Michi-Tsubaki/dynamic_heartbeat/cad/base/Assembly.SLDASM

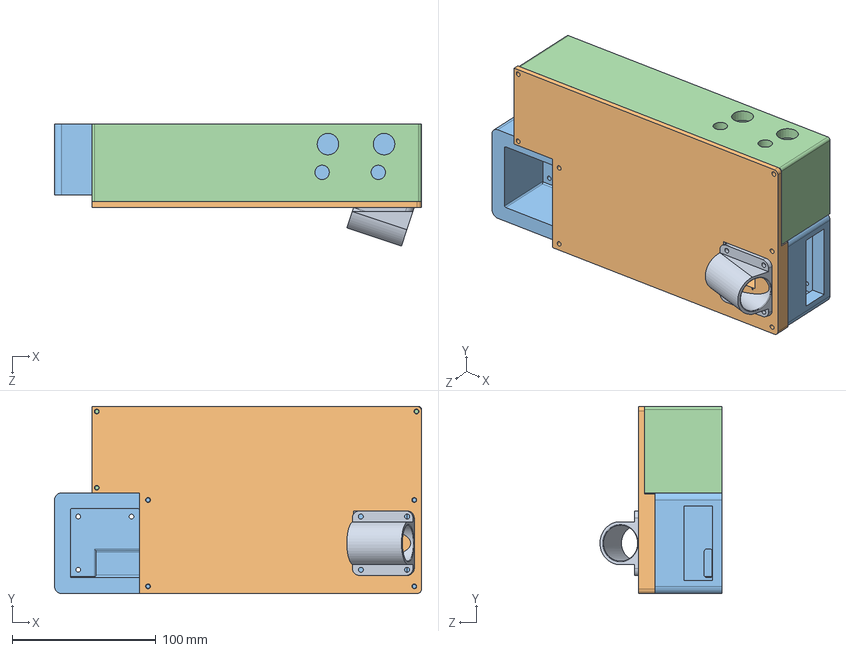
[picture p2: CAD file, 2026-11-08]
cad/base/Assembly.SLDASM
255.0 x 130.0 x 84.8 mm
air_pump_base
water_pump_base
top
finger_socket
