Michi-Tsubaki/dynamic_heartbeat/cad/base/sldprt/finger_socket.SLDPRT

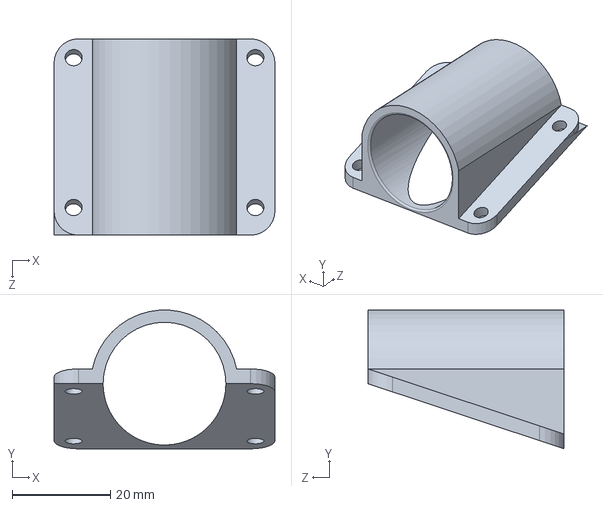
[picture p3: CAD file, 2026-11-08]
cad/base/sldprt/finger_socket.SLDPRT
45.0 x 28.2 x 40.0 mm
