Michi-Tsubaki/dynamic_heartbeat/cad/mold/stl/heart_mold_A_base.stl

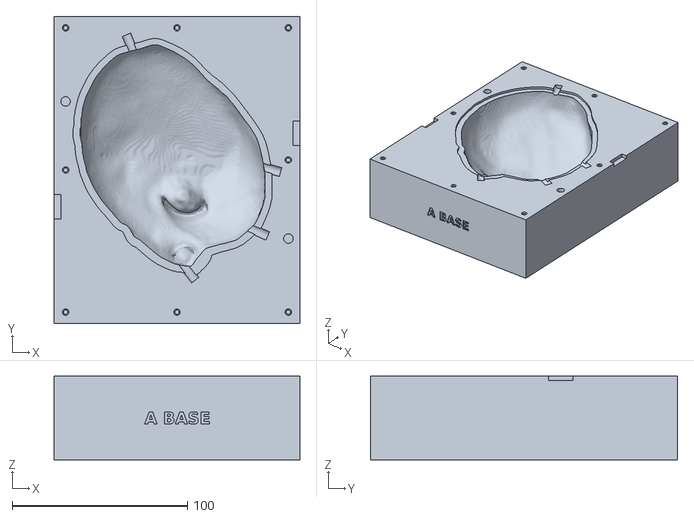
[picture p4: CAD file, 2026-11-08]
cad/mold/stl/heart_mold_A_base.stl
140.0 x 175.0 x 47.8
