Michi-Tsubaki/dynamic_heartbeat/parts/linear_silinder_connector.SLDPRT

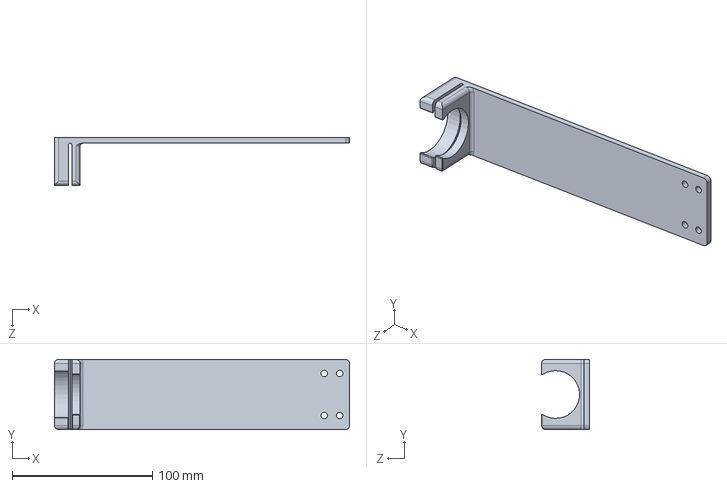
[picture p5: CAD file, 2026-10-04]
parts/linear_silinder_connector.SLDPRT
210.0 x 50.0 x 34.0 mm
