Michi-Tsubaki/dynamic_heartbeat/cad/base/sldprt/top.SLDPRT

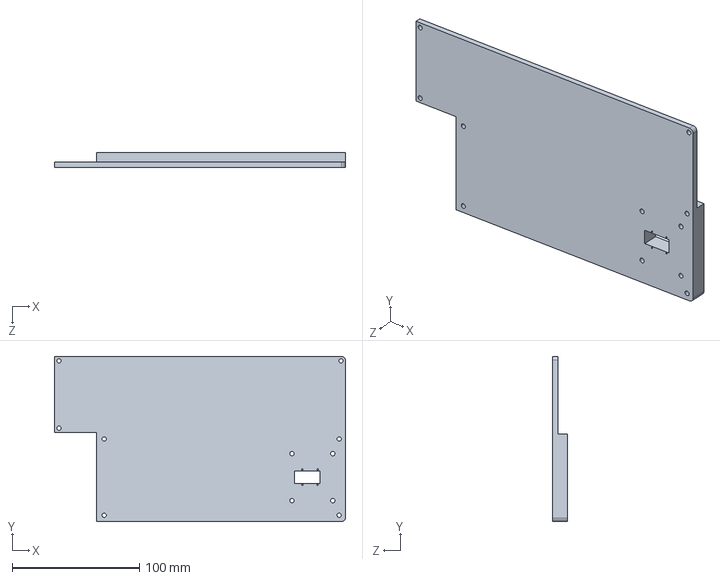
[picture p6: CAD file, 2026-11-08]
cad/base/sldprt/top.SLDPRT
229.1 x 130.0 x 11.5 mm
