Michi-Tsubaki/dynamic_heartbeat/cad/mold/stl/heart_mold_B_lid.stl

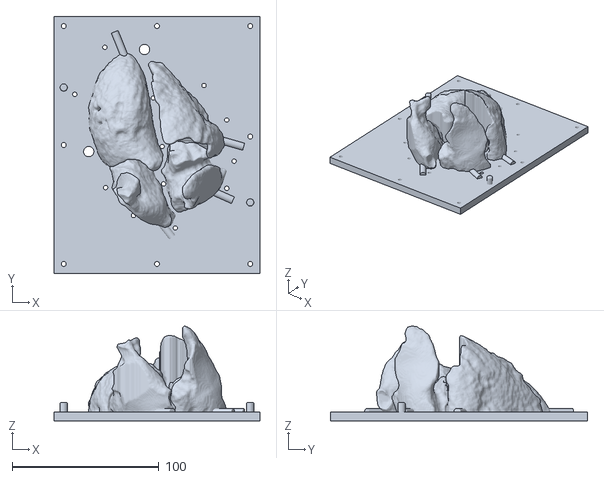
[picture p7: CAD file, 2026-11-08]
cad/mold/stl/heart_mold_B_lid.stl
140.0 x 175.0 x 64.5
