Michi-Tsubaki/dynamic_heartbeat/parts/silinder_parts.SLDPRT

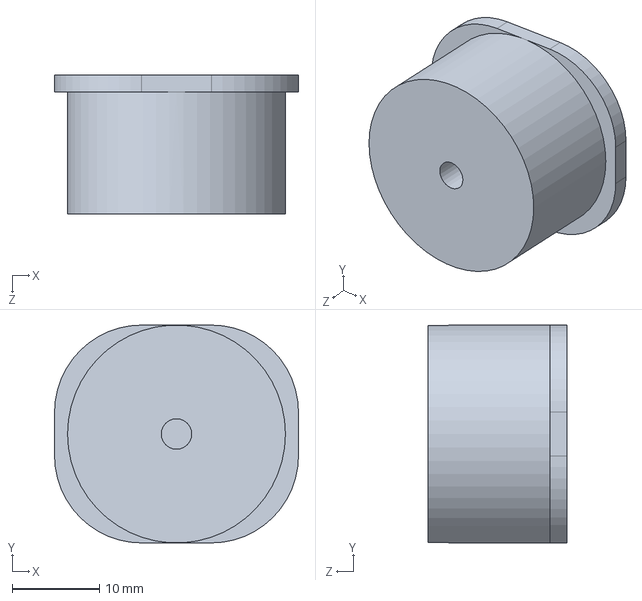
[picture p8: CAD file, 2026-10-04]
parts/silinder_parts.SLDPRT
28.0 x 25.0 x 16.0 mm
