Michi-Tsubaki/dynamic_heartbeat/cad/base/sldprt/water_pump_base.SLDPRT

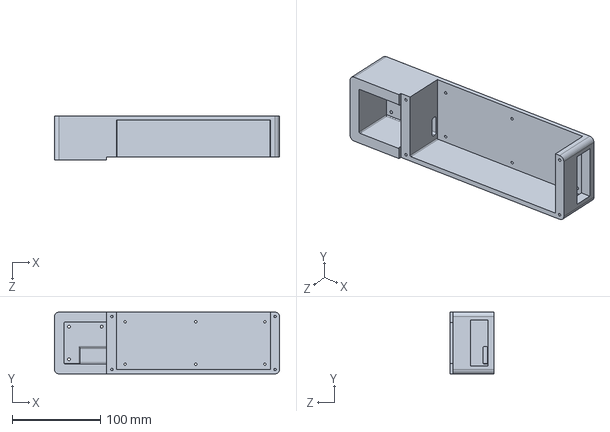
[picture p9: CAD file, 2026-11-02]
cad/base/sldprt/water_pump_base.SLDPRT
255.0 x 70.0 x 49.5 mm
