Michi-Tsubaki/dynamic_heartbeat/cad/base/sldprt/air_pump_base.SLDPRT

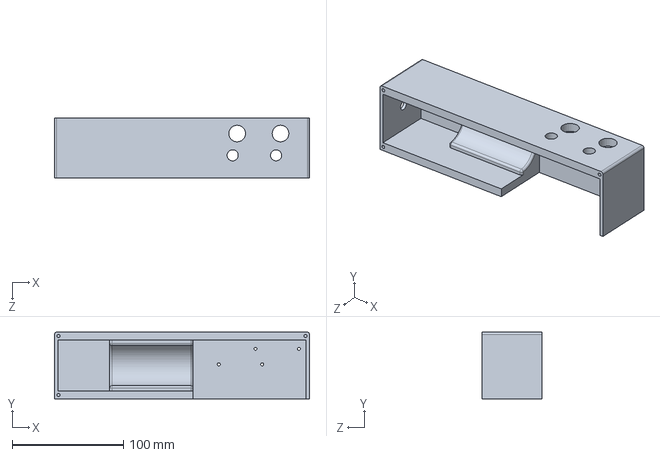
[picture p11: CAD file, 2026-11-02]
cad/base/sldprt/air_pump_base.SLDPRT
229.1 x 60.0 x 54.0 mm
