Michi-Tsubaki/dynamic_heartbeat/(list of files, cad)

Other CAD files:
cad/base/stl/air_pump_base.STL
cad/base/stl/finger_socket.STL
cad/base/stl/top.STL
cad/base/stl/water_pump_base.STL
parts/linear_silinder_connector.STL
parts/silinder_parts.STL
