Michi-Tsubaki/dynamic_heartbeat/(commit log)

2026-11-01 Add heatbeat sound
2026-11-02 Remove old cad files and add pump base cad files instead
    [air_pump_base.SLDPRT, air_pump_base.STL, linear_silinder_connector.SLDPRT, linear_silinder_connector.STL, silinder_parts.SLDPRT, silinder_parts.STL, water_pump_base.SLDPRT, water_pump_base.STL]
2026-11-02 Refactor actuator tests
2026-11-02 Temporaly ommit valve2
2026-11-02 Add mold cad
    [air_pump_base.SLDPRT, air_pump_base.STL, heart_mold_A_base.stl, heart_mold_A_lid.stl, heart_mold_B_base.stl, heart_mold_B_lid.stl, linear_silinder_connector.SLDPRT, linear_silinder_connector.STL]
2026-11-04 Fix spurious safety stop caused by millis underflow
    safetyCheck() compared atriumFillStart, set with millis() inside setAir(), against the older loop-start time, so the unsigned difference underflowed and vented the atrium right after a cycle started.
    [heartbeat.ino]
2026-11-04 Sync BPM to MAX30102 pulse sensor
    Read the sensor over software I2C on A0/A1 (SDA/SCL order auto-detected) and set the BPM to the median of the last 5 detected beats.
2026-11-04 Rest while no finger is on the pulse sensor
    Vent and stop after the finger has been off for 2 s, and resume after it has been on for 0.5 s.
2026-11-08 Update CAD (Add top cover)
    [Assembly.SLDASM, finger_socket.SLDPRT, finger_socket.STL, top.SLDPRT, top.STL]
